Bajtii/Line-follower-with-obstacle-avoiding/README.md

# Line Follower Robot with Obstacle Detection

An autonomous **line follower robot** enhanced with **obstacle detection** functionality. The project combines mechanics, electronics, and programming to build a mobile robot that can follow a predefined path and intelligently avoid obstacles using ultrasonic sensors.



---

## 🛠️ Mechanical Design

The mechanical structure was fully designed in SolidWorks. Key components include:

- **Base and cover** – 3D printed in PLA
- **Drive system** – 2× N20-BT38 micro motors (250:1, 120RPM)
- **Wheels** – Pololu 1087 (32×7 mm)
- **Caster ball** – Pololu 2691 ball caster
- **Ultrasonic sensor mount** – transparent acrylic bracket


---

## 🔌 Electronics

The electronic system includes:

- **Arduino Uno Rev3**
- **L298N dual H-bridge motor driver**
- **HC-SR04 ultrasonic distance sensor**
- **TCRT5000 LM393 IR reflective sensor**
- **SG-90 servo motor**
- **18650 Li-ion battery**
- **Rocker switch**











### 🧠 Algorithm Description

The robot uses a **hybrid control algorithm** that combines **line following** and **obstacle avoidance**:

#### 🚗 Line Following

- IR sensors underneath detect a black line on a light background.
- Movement logic:
  - Left sensor sees black → slight left turn
  - Right sensor sees black → slight right turn
  - Both see black → go forward
  - Both see white → stop or reverse and re-center

#### 🚧 Obstacle Avoidance

- The ultrasonic sensor scans ahead using a mounted servo.
- If an object is closer than a threshold (e.g., 20 cm), the robot:
  1. Stops
  2. Rotates the servo to scan left/right
  3. Chooses the direction with more space
  4. Turns accordingly
  5. Re-centers and resumes line tracking

#### 🔄 Switching Logic

| Condition | Action |
|---|---|
| Line detected, no obstacle  | Follow the line |
| Obstacle detected | Pause line tracking → avoid obstacle |
| Obstacle cleared | Resume line tracking |

---

## 🧪 Features & Testing

- Obstacle detection range: 2–200 cm
- Collision avoidance logic
- Adjustable IR sensor sensitivity
- Track-following: straights, turns, and obstacles
- Speed tuning and calibration



---

## 📄 Technical Documentation

📎 [Download Full Report (PDF)](https://github.com/Bajtii/Line-follower-with-obstacle-avoiding/blob/main/Linefollower_documentation.pdf)  
Includes hardware schematics, control algorithm explanation, sensor placement, and performance test results.

---

## 👨‍🔧 Author

**Bartosz Wojdon**  
Mechatronics Engineering, AGH University of Science and Technology  
Academic Year 2024/2025
